hanluu0710/ece_362_final_proj/README.md

# ece_362_final_proj
Pocket oscilloscope
