hanluu0710/ece_362_final_proj/Proton-KiCAD/BAT60JFILM/CR_60JFILM_STM.step

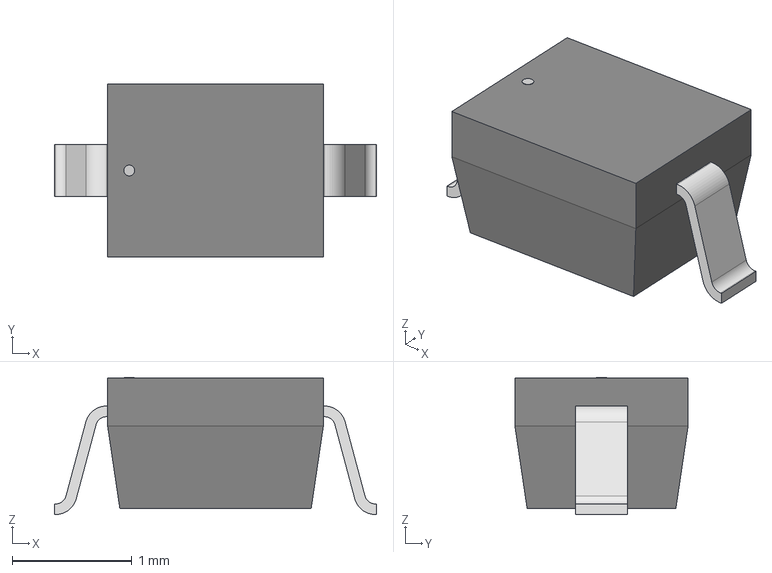
[picture p1: CAD file, 2025-11-14]
Proton-KiCAD/BAT60JFILM/CR_60JFILM_STM.step
2.69 x 1.45 x 1.15 mm
