hanluu0710/ece_362_final_proj/Proton-KiCAD/RP2350_QFN80.step

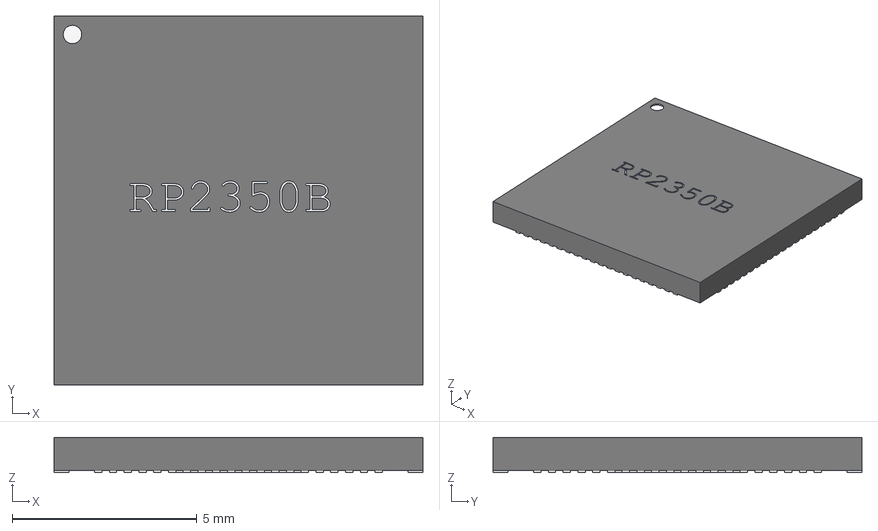
[picture p2: CAD file, 2025-11-14]
Proton-KiCAD/RP2350_QFN80.step
10.0 x 10.0 x 0.95 mm
