hanluu0710/ece_362_final_proj/Proton-KiCAD/SN74AUP1T17DCKR/DCK0005A.stp

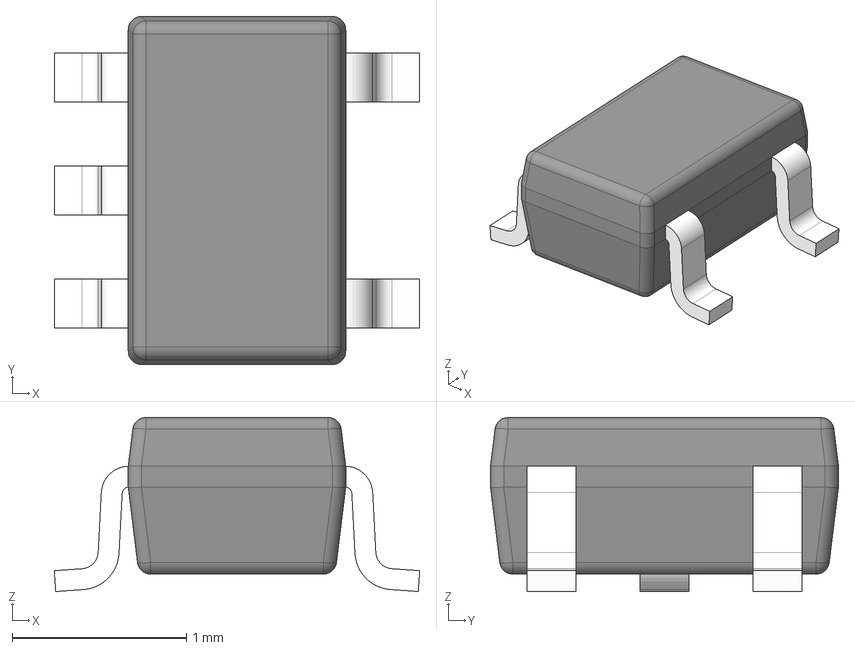
[picture p3: CAD file, 2025-11-14]
Proton-KiCAD/SN74AUP1T17DCKR/DCK0005A.stp
2.10 x 2.00 x 1.00 mm
BODY-SOT
LEAD-SOT x 5
PIN1-ID
