hanluu0710/ece_362_final_proj/Proton-KiCAD/W25Q16JVUXIQ_TR/USON-8_UX_2x3x0p6_WIN.step

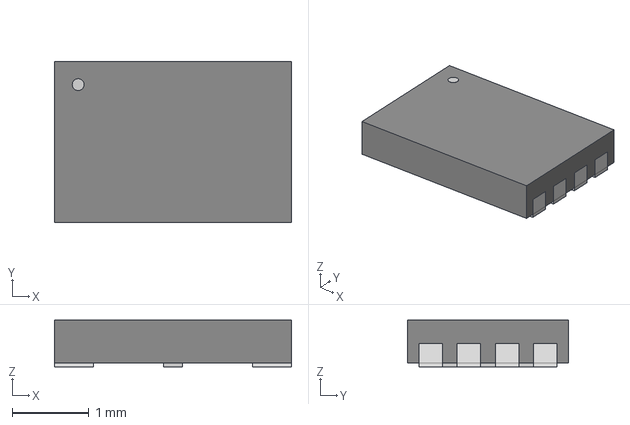
[picture p4: CAD file, 2025-11-14]
Proton-KiCAD/W25Q16JVUXIQ_TR/USON-8_UX_2x3x0p6_WIN.step
3.10 x 2.11 x 0.612 mm
