hanluu0710/ece_362_final_proj/CIRCUIT/ECE_362_final_proj.kicad_pcb

## KiCad design CIRCUIT/ECE_362_final_proj.kicad_pcb (2025-12-08)

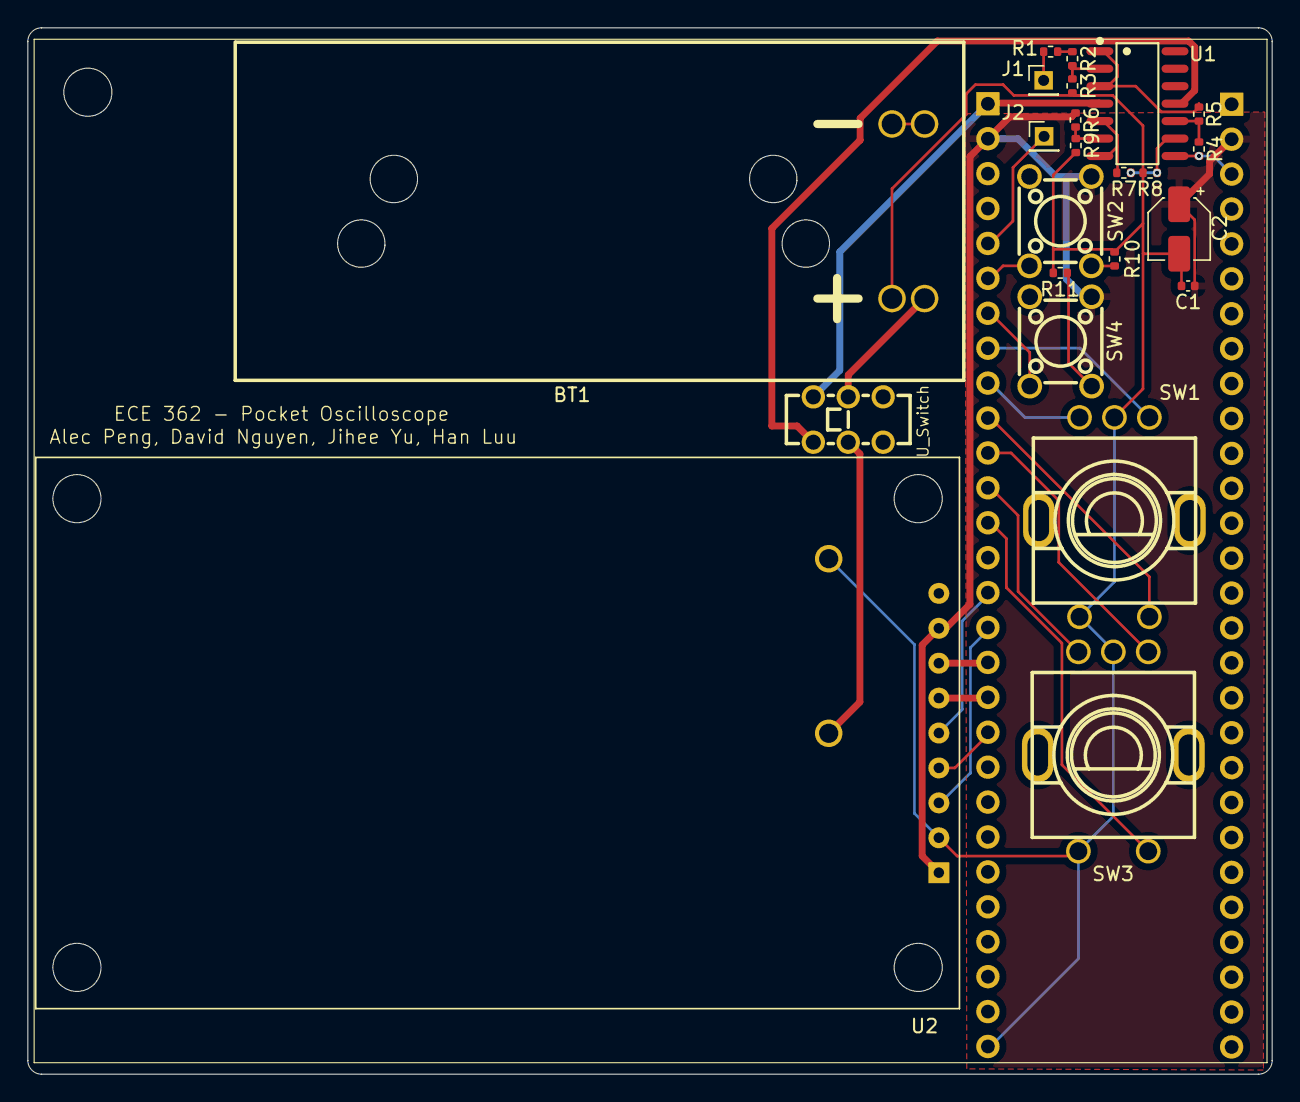
[picture p5: board ECE_362_final_proj.kicad_pcb from above]

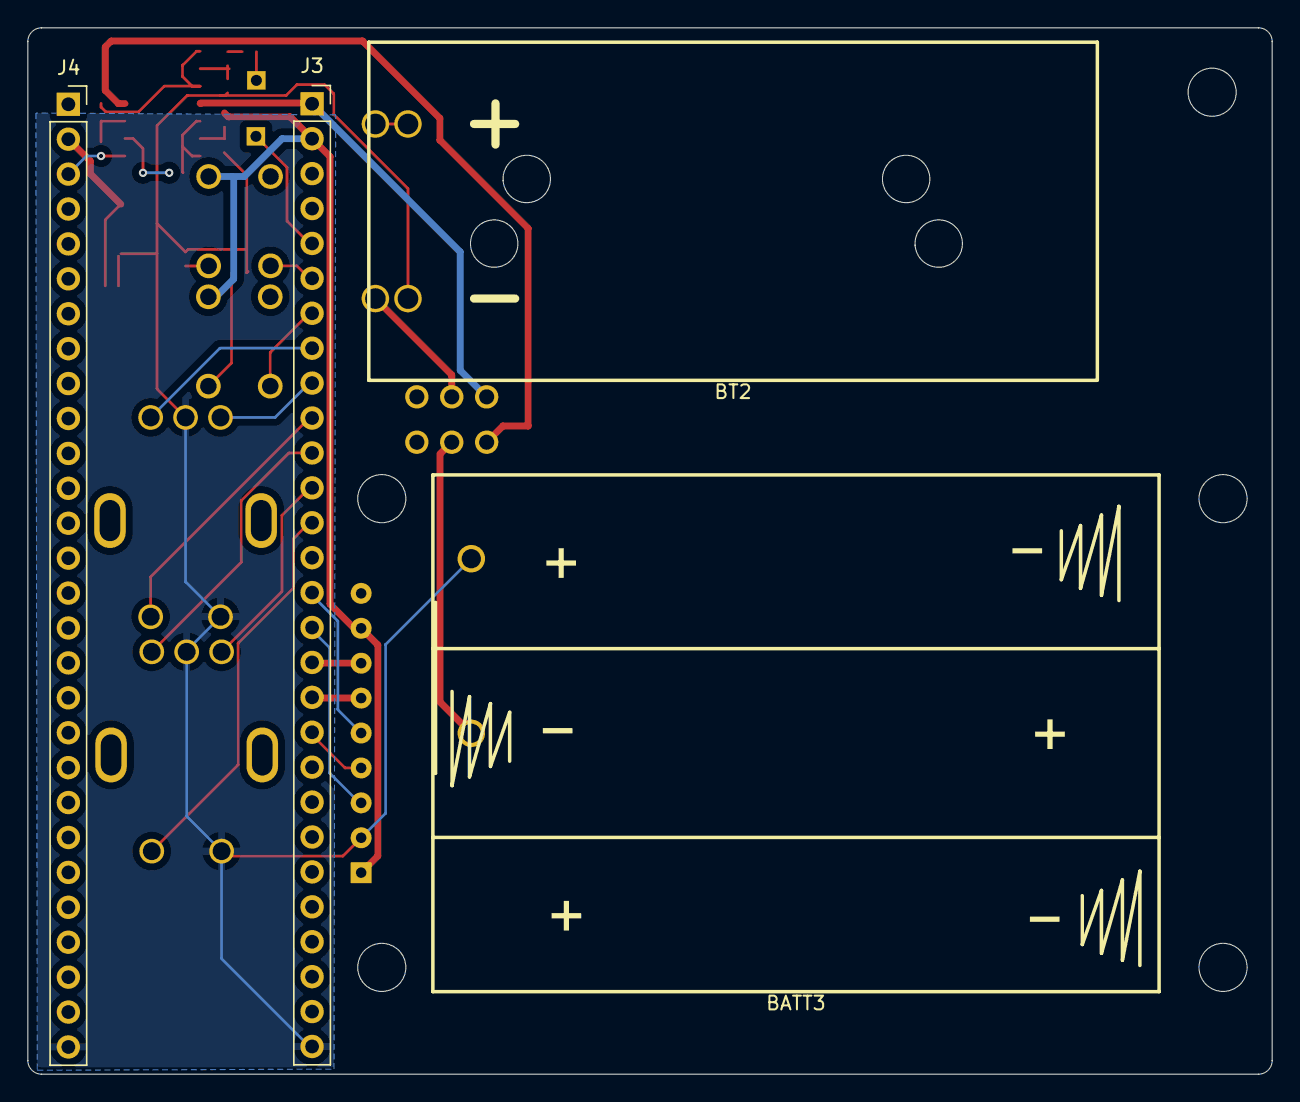
[picture p6: board ECE_362_final_proj.kicad_pcb from below]

Board: 2 copper layers, 90.5 x 76.1 mm, 27 parts (4 on the bottom side), 32 nets.

Parts:
BATT3: BAT-TH_2479
BT1, BT2: BAT-TH_2P-L53.0-W24.6-P12.70_2468
C1: .1uF; C_0402_1005Metric
C2: 10uF; CP_Elec_4x4.5
J1, J2: Conn_01x01_Pin; PinHeader_1x01_P2.00mm_Vertical
J3, J4: Conn_01x28_Socket; PinSocket_1x28_P2.54mm_Vertical
R1: 680k; R_0402_1005Metric
R2: 220k; R_0402_1005Metric
R3: 100k; R_0402_1005Metric
R4, R5, R6, R7, R8, R9: 10k; R_0402_1005Metric
R10, R11: 1000; R_0402_1005Metric
SW1, SW3: SW-TH_EC11E18244A5
SW2: BUTTON_MODE; SW-TH_4P-L6.0-W6.0-P4.50-LS6.5
SW4: BUTTON_CAPTURE; SW-TH_4P-L6.0-W6.0-P4.50-LS6.5
U1: TL084; SOP-14_L8.6-W3.9-P1.27-LS6.0-BL
U2: LCD_MSP2202_without_sd
U_Switch: SW-TH_SSSS222700

Connections:
+3.3V: C1.1, C2.1, J3.2, J4.2, R6.1, SW2.4 (A), SW4.4 (A), U2.1, U2.8
+BATT: J3.1, J4.1, U1.4 (V+), U_Switch.1
-BATT: U1.11 (V-), U_Switch.4
/GPIO2: J2.1, J3.5
/GPIO3: J3.6, SW2.1
/GPIO4: J3.7, SW4.1
/GPIO5: J3.8, SW1.A
/GPIO6: J3.9, SW1.B
/GPIO7: J3.10, SW1.D
/GPIO8: J3.11, SW3.A
/GPIO9: J3.12, SW3.B
/GPIO10: J3.13, SW3.D
/GPIO12: J3.15, U2.5
/GPIO13: J3.16, U2.3
/GPIO14: J3.17, U2.7
/GPIO15: J3.18, U2.6
/GPIO16: J3.19, U2.4
/GPIO47_ADC7: J4.3, R4.2, U1.8
BAT3: BATT3.2, U_Switch.5
BT1+: BT1.2, U_Switch.2
BT1_GND: BT1.1, BT2.2
GND: BATT3.1, BT2.1, C1.2, C2.2, J3.28, J4.28, R3.2, R8.2, R9.2, R10.2, R11.2, SW1.C, SW1.E, SW3.C, SW3.E, U2.2
unnamed: J1.1, R1.1
unnamed: R1.2, R2.1
unnamed: R10.1, SW2.3 (K)
unnamed: R11.1, SW4.3 (K)
unnamed: R5.1, U1.1, U1.3 (+)
unnamed: R2.2, R3.1, U1.2 (-)
unnamed: R7.2, U1.5 (+), U1.7
unnamed: R6.2, R9.1, U1.6 (-)
unnamed: R4.1, R5.2, U1.10 (+)
unnamed: R7.1, R8.1, U1.9 (-)
