hanluu0710/ece_362_final_proj/adc.c

#include <stdio.h>
#include <string.h>
#include "pico/stdlib.h"
#include "hardware/timer.h"
#include "hardware/irq.h"
#include "hardware/adc.h"
#include "hardware/dma.h"
#include <math.h>

//////////////////////////////////////////////////////////////////////////////

// BUFFER_SIZE must be a power of 2. This is the number of samples in the buffer, not bytes
#define BUFFER_SIZE 2 //= 32768 bytes / 8; Max size is 16384 samples = 32768 bytes / 2
uint16_t adc_fifo_out[BUFFER_SIZE] __attribute__((aligned(BUFFER_SIZE * 2)));

//////////////////////////////////////////////////////////////////////////////

/*
void init_adc_freerun() {
    adc_init();
    adc_gpio_init(47);
    adc_select_input(7);
    adc_run(true);

}*/

void init_dma() {
    dma_channel_set_read_addr(7, &adc_hw->fifo, false);
    dma_channel_set_write_addr(7, &adc_fifo_out, false);
    dma_channel_hw_addr(7)->transfer_count = 0x10000001;
    
    /*
    for (int i = 0; i < BUFFER_SIZE; i++) {
        adc_fifo_out[i] = i;
    }
    */

    uint32_t temp;
    temp = (48 << DMA_CH0_CTRL_TRIG_TREQ_SEL_LSB)           // Select ADC as TREQ source
        |  (1 << DMA_CH0_CTRL_TRIG_RING_SEL_LSB)            // Ring select (write address increments)
        |  (__builtin_ctz(BUFFER_SIZE * 2)
            << DMA_CH0_CTRL_TRIG_RING_SIZE_LSB)             // Ring size (2^15 bytes)
        |  (1 << DMA_CH0_CTRL_TRIG_INCR_WRITE_LSB)          // Increment address after write
        |  (1 << DMA_CH0_CTRL_TRIG_DATA_SIZE_LSB)           // Select halfword (16 bits)
        |  (1 << DMA_CH0_CTRL_TRIG_EN_LSB);                 // Enable
    dma_hw->ch[7].ctrl_trig = temp;
}

void init_adc_dma() {
    adc_init();

    // Enable ADC GPIO
    adc_gpio_init(47);          // GPIO 47 = ADC7 input
    adc_select_input(7);        // Select ADC channel 7

    // Fastest sampling (48 MHz)
    adc_set_clkdiv(0);

    // Configure FIFO BEFORE running ADC
    adc_fifo_setup(
        true,    // Write each sample to FIFO
        true,    // Enable DMA request
        1,       // DREQ on every sample
        false,   // No ERR bit
        false    // 12-bit mode (default)
    );

    // Now DMA init
    init_dma();

    // Finally start ADC
    adc_run(true);
}

uint16_t adc_get_sample(uint32_t i)
{
    // Convert base pointer to byte pointer
    uint8_t *base = (uint8_t *)adc_fifo_out;

    // Read DMA next-write address
    uint32_t next = dma_hw->ch[7].write_addr;

    // Compute byte offset of the i-th most recent sample
    // -2 for most recent
    // -(i * 2) for arbitrary sample i
    uint32_t offset = (next - (uint32_t)base - 2 - (i * 2));    // Move back 1 + i samples
    offset &= ((BUFFER_SIZE * 2) - 1);                          // Wrap around if necessary

    // Convert back to uint16_t pointer and return the sample
    return *(uint16_t *)(base + offset);
}

//////////////////////////////////////////////////////////////////////////////

// int main()
// {
//     // Configures our microcontroller to 
//     // communicate over UART through the TX/RX pins
//     stdio_init_all();

//     init_adc_dma();

//     uint16_t recent[10];
//     for(;;) {
//         // 0 = latest sample
//         // 1 = second latest sample
//         // etc
//         for (int i = 0; i < 10; i++) {
//             recent[i] = adc_get_sample(i);
//         }
//     }

//     for(;;);
//     return 0;
// }
