hanluu0710/ece_362_final_proj/(commit log)

2025-11-14 button and rotary encoder sch upload
    [button and encoder diagram.kicad_sch]
2025-11-14 combined circuit
    [ECE_362_final_proj.kicad_pcb, ECE_362_final_proj.kicad_sch]
2025-11-15 There is still a debouncing issue with the rotary, but I GOT IT TO DECREASE KDJFSFHSGJSFGSJVVFH
    [button_and_rotary.c]
2025-11-18 PCB lowkey done
    [ECE_362_final_proj.kicad_pcb, ECE_362_final_proj.kicad_sch, Proton.kicad_pcb]
2025-11-18 added mounting holes
    [ECE_362_final_proj.kicad_pcb]
2025-11-18 rearranged board
    [ECE_362_final_proj.kicad_pcb, ECE_362_final_proj.kicad_sch]
2025-11-18 clean up folder
    [ECE_363_disp.kicad_sch, SignalConditioner.kicad_sch, button and encoder diagram.kicad_sch]
2025-11-18 adjusted trace width
    [ECE_362_final_proj.kicad_pcb]
2025-11-19 adjusted silkscreen
    [ECE_362_final_proj.kicad_pcb]
2025-11-19 adjusted signal window size
    [ECE_362_final_proj.kicad_pcb]
2025-11-20 PCB DONE
    [ECE_362_final_proj-B_Cu.gbr, ECE_362_final_proj-B_Mask.gbr, ECE_362_final_proj-B_Paste.gbr, ECE_362_final_proj-B_Silkscreen.gbr, ECE_362_final_proj-Edge_Cuts.gbr, ECE_362_final_proj-F_Cu.gbr, ECE_362_final_proj-F_Mask.gbr, ECE_362_final_proj-F_Paste.gbr]
2025-11-26 fixed display scroll mode
    [adc.c, button_and_rotary.c, main.c]
2025-11-27 still trying to relate adc to pixel
2025-11-28 capture and mode buttons might be floating, added a modified version for cross checking
    [ECE_362_final_proj.kicad_sch]
2025-11-28 previous code has overlapping interrupt, this should work but still no zooming when paused though
2025-11-28 Add PWM wave generation initialization
    Initialize PWM for wave generation with sine wave settings.
2025-11-28 Add wave generator with PWM control
    Implement wave generator functionality with PWM output.
2025-11-28 ADC works
2025-12-01 I fixed some syntax errors and modified some codes in wavegen.c and wavegen.h
    [wavegen.c, wavegen.h]
2025-12-08 final circuit
    [ECE_362_final_proj.kicad_pcb, ECE_362_final_proj.kicad_sch, bom.csv, designators.csv, positions.csv]
